MicroType-Engineering/MTE_USB_HUB/README.md

MTE_USB_HUB

As designed on the MicroType Engineering's YouTube series: https://youtu.be/uzqXgHHZUUs
