MicroType-Engineering/MTE_USB_HUB/kicad_proj/mte_usb_hub/mte_usb_hub.kicad_pcb

## KiCad design kicad_proj/mte_usb_hub/mte_usb_hub.kicad_pcb (2021-07-17)

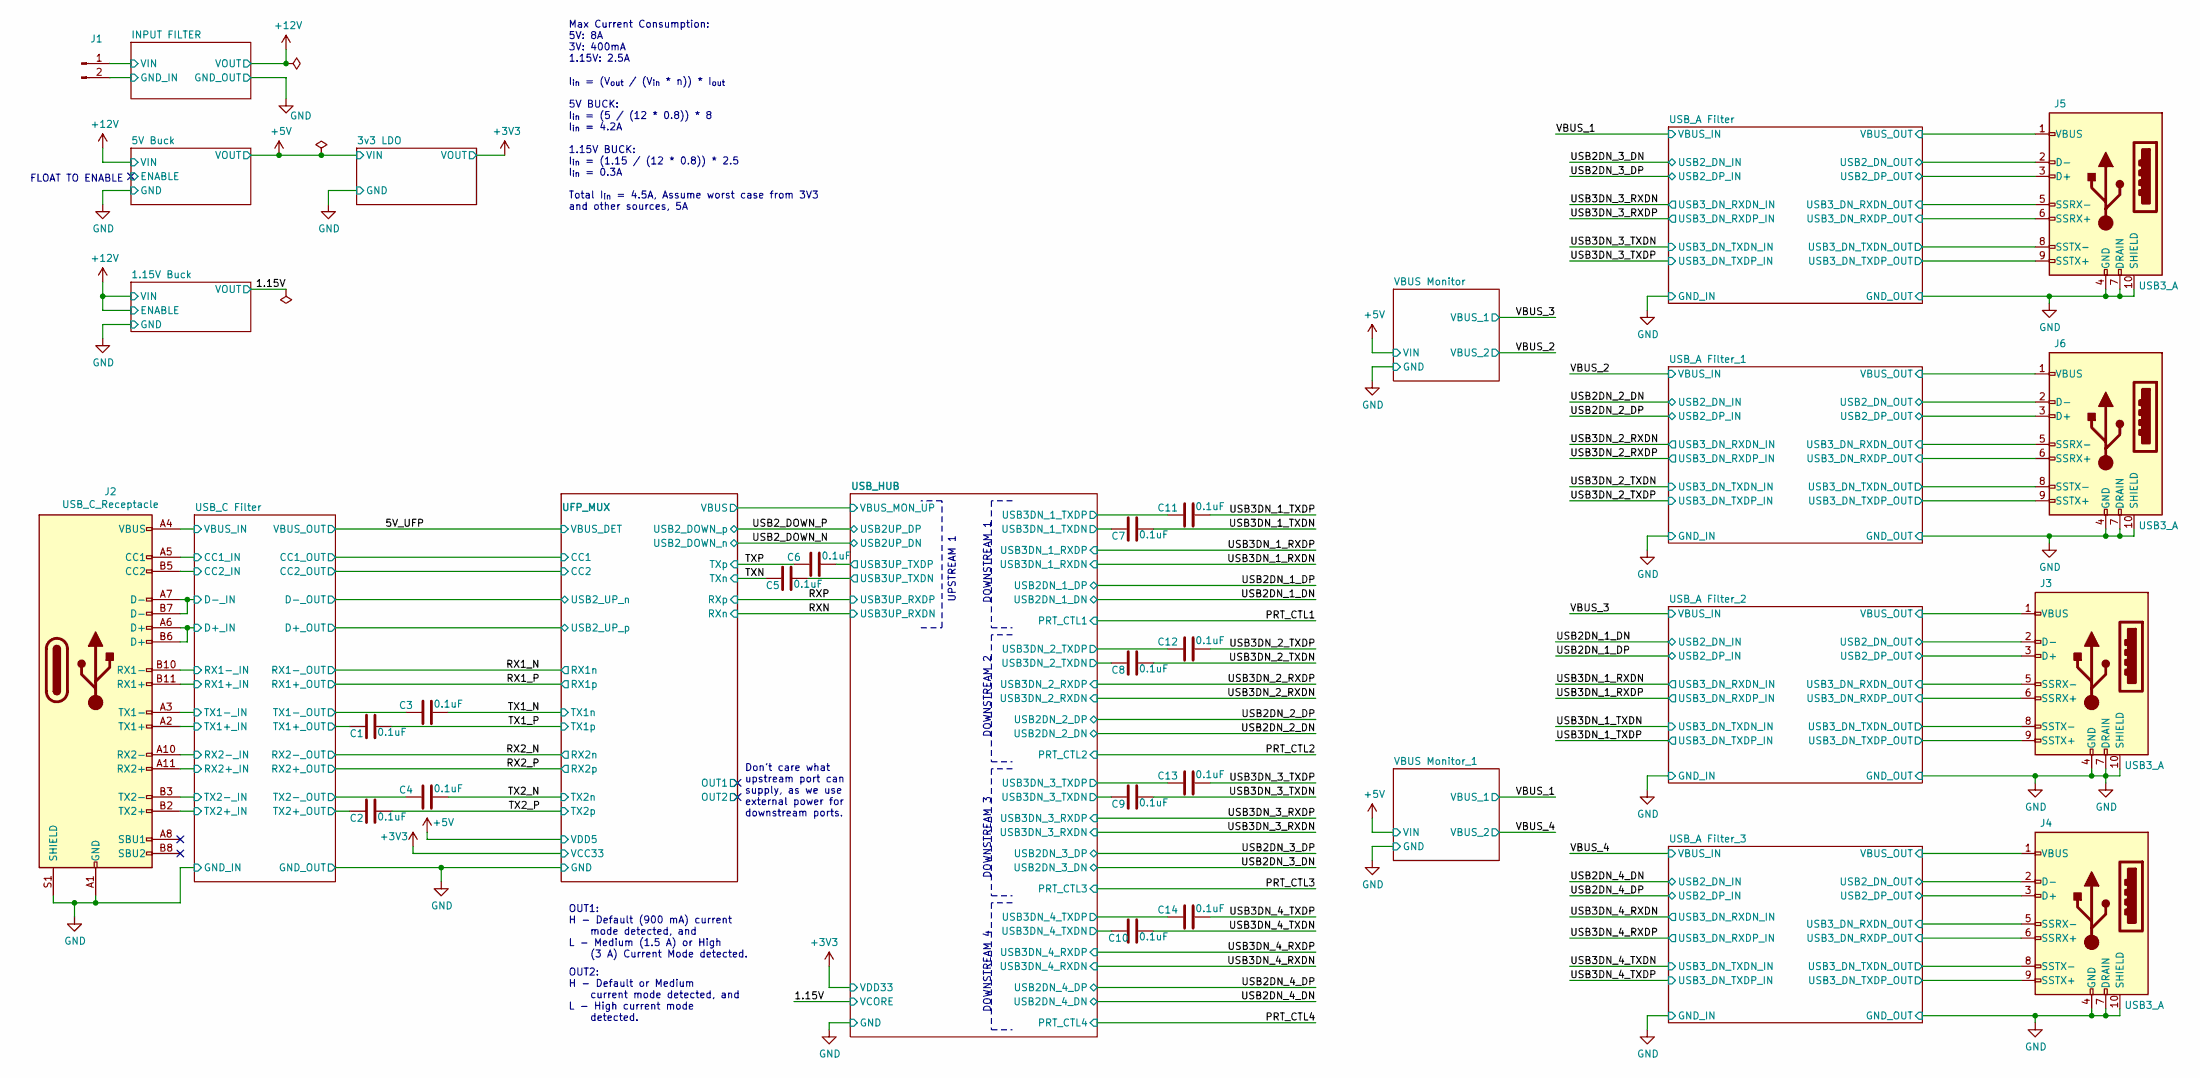
[picture p1: schematic mte_usb_hub.kicad_sch]

Parts:
C1, C2, C3, C4, C5, C6, C7, C8, C9, C10, C11, C12, C13, C14: CC0402KRX5R7BB104; CAPACITOR_0402N
J1: Conn_01x02_Male; PinHeader_1x02_P2.54mm_Vertical
J2: USB_C_Receptacle; USB_C_Receptacle_Amphenol_12401610E4-2A
J3, J4, J5, J6: USB3_A; USB3_A_Molex_48393-001

Connections:
/5V_UFP: J2.A4 (VBUS), J2.A9 (VBUS), J2.B4 (VBUS), J2.B9 (VBUS); also elsewhere on the board
/INPUT FILTER/GND_IN: J1.2; also elsewhere on the board
/INPUT FILTER/VIN: J1.1; also elsewhere on the board
/RX1_N: J2.B10 (RX1-); also elsewhere on the board
/RX1_P: J2.B11 (RX1+); also elsewhere on the board
/RX2_N: J2.A10 (RX2-); also elsewhere on the board
/RX2_P: J2.A11 (RX2+); also elsewhere on the board
/TX1_N: C3.2; also elsewhere on the board
/TX1_P: C1.2; also elsewhere on the board
/TX2_N: C4.2; also elsewhere on the board
/TX2_P: C2.2; also elsewhere on the board
/TXN: C5.1; also elsewhere on the board
/TXP: C6.1; also elsewhere on the board
/UFP_MUX/CC1: J2.A5 (CC1); also elsewhere on the board
/UFP_MUX/CC2: J2.B5 (CC2); also elsewhere on the board
/USB2DN_1_DN: J3.2 (D-); also elsewhere on the board
/USB2DN_1_DP: J3.3 (D+); also elsewhere on the board
/USB2DN_2_DN: J6.2 (D-); also elsewhere on the board
/USB2DN_2_DP: J6.3 (D+); also elsewhere on the board
/USB2DN_3_DN: J5.2 (D-); also elsewhere on the board
/USB2DN_3_DP: J5.3 (D+); also elsewhere on the board
/USB2DN_4_DN: J4.2 (D-); also elsewhere on the board
/USB2DN_4_DP: J4.3 (D+); also elsewhere on the board
/USB2_DOWN_N: J2.A7 (D-), J2.B7 (D-); also elsewhere on the board
/USB2_DOWN_P: J2.A6 (D+), J2.B6 (D+); also elsewhere on the board
/USB3DN_1_RXDN: J3.5 (SSRX-); also elsewhere on the board
/USB3DN_1_RXDP: J3.6 (SSRX+); also elsewhere on the board
/USB3DN_1_TXDN: C7.2, J3.8 (SSTX-); also elsewhere on the board
/USB3DN_1_TXDP: C11.2, J3.9 (SSTX+); also elsewhere on the board
/USB3DN_2_RXDN: J6.5 (SSRX-); also elsewhere on the board
/USB3DN_2_RXDP: J6.6 (SSRX+); also elsewhere on the board
/USB3DN_2_TXDN: C8.2, J6.8 (SSTX-); also elsewhere on the board
/USB3DN_2_TXDP: C12.2, J6.9 (SSTX+); also elsewhere on the board
/USB3DN_3_RXDN: J5.5 (SSRX-); also elsewhere on the board
/USB3DN_3_RXDP: J5.6 (SSRX+); also elsewhere on the board
/USB3DN_3_TXDN: C9.2, J5.8 (SSTX-); also elsewhere on the board
/USB3DN_3_TXDP: C13.2, J5.9 (SSTX+); also elsewhere on the board
/USB3DN_4_RXDN: J4.5 (SSRX-); also elsewhere on the board
/USB3DN_4_RXDP: J4.6 (SSRX+); also elsewhere on the board
/USB3DN_4_TXDN: C10.2, J4.8 (SSTX-); also elsewhere on the board
/USB3DN_4_TXDP: C14.2, J4.9 (SSTX+); also elsewhere on the board
/USB_C Filter/_TX1+: C1.1, J2.A2 (TX1+); also elsewhere on the board
/USB_C Filter/_TX1-: C3.1, J2.A3 (TX1-); also elsewhere on the board
/USB_C Filter/_TX2+: C2.1, J2.B2 (TX2+); also elsewhere on the board
/USB_C Filter/_TX2-: C4.1, J2.B3 (TX2-); also elsewhere on the board
/USB_HUB/USB3DN_1_TXDN: C7.1; also elsewhere on the board
/USB_HUB/USB3DN_1_TXDP: C11.1; also elsewhere on the board
/USB_HUB/USB3DN_2_TXDN: C8.1; also elsewhere on the board
/USB_HUB/USB3DN_2_TXDP: C12.1; also elsewhere on the board
/USB_HUB/USB3DN_3_TXDN: C9.1; also elsewhere on the board
/USB_HUB/USB3DN_3_TXDP: C13.1; also elsewhere on the board
/USB_HUB/USB3DN_4_TXDN: C10.1; also elsewhere on the board
/USB_HUB/USB3DN_4_TXDP: C14.1; also elsewhere on the board
/USB_HUB/USB3UP_TXDN: C5.2; also elsewhere on the board
/USB_HUB/USB3UP_TXDP: C6.2; also elsewhere on the board
/VBUS_1: J5.1 (VBUS); also elsewhere on the board
/VBUS_2: J6.1 (VBUS); also elsewhere on the board
/VBUS_3: J3.1 (VBUS); also elsewhere on the board
/VBUS_4: J4.1 (VBUS); also elsewhere on the board
GND: J2.A1 (GND), J2.A12 (GND), J2.B1 (GND), J2.B12 (GND), J2.S1 (SHIELD), J3.4 (GND), J3.7 (DRAIN), J3.10 (SHIELD), J4.4 (GND), J4.7 (DRAIN), J4.10 (SHIELD), J5.4 (GND), J5.7 (DRAIN), J5.10 (SHIELD), J6.4 (GND), J6.7 (DRAIN), J6.10 (SHIELD); also elsewhere on the board

Notes on the sheet:
FLOAT TO ENABLE
Max Current Consumption: 5V: 8A 3V: 400mA 1.15V: 2.5A
I_{in} = (V_{out} / (V_{in} * n)) * I_{out} 5V BUCK: I_{in} = (5 / (12 * 0.8)) * 8 I_{in} = 4.2A 1.15V BUCK: I_{in} = (1.15 / (12 * 0.8)) * 2.5 I_{in} = 0.3A Total I_{in} = 4.5A, Assume worst case from 3V3 and other sources, 5A
OUT1: H - Default (900 mA) current mode detected, and L - Medium (1.5 A) or High (3 A) Current Mode detected.
OUT2: H - Default or Medium current mode detected, and L - High current mode detected.
Don't care what upstream port can supply, as we use external power for downstream ports.
UPSTREAM 1
DOWNSTREAM 1
DOWNSTREAM 2
DOWNSTREAM 3
DOWNSTREAM 4

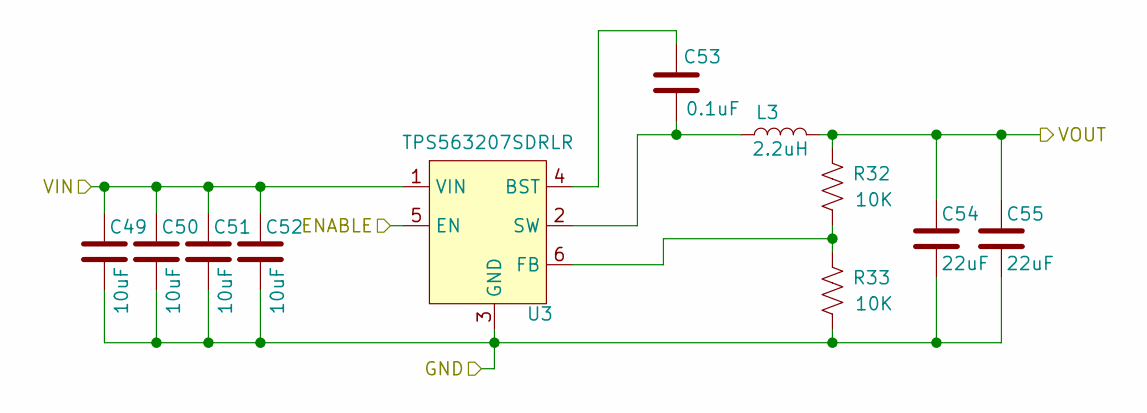
[picture p2: schematic 1.15v_buck.kicad_sch]

Parts:
C49, C50, C51, C52: GRM31CR71E106KA12L; CAPACITOR_1206N
C53: CC0402KRX5R7BB104; CAPACITOR_0402N
C54, C55: CL21A226MOCLRNC; CAPACITOR_0805N
L3: 74405042022; INDM400X400X200L95X310N
R32, R33: RC0402JR-0710KL; RESISTOR_0402N
U3: TPS563207SDRLR; SOL6P50_160X160X60L21N

Connections:
+12V: C49.1, C50.1, C51.1, C52.1, U3.1 (VIN), U3.5 (EN); also elsewhere on the board
/1.15V: C54.1, C55.1, L3.2, R32.1; also elsewhere on the board
GND: C49.2, C50.2, C51.2, C52.2, C54.2, C55.2, R33.2, U3.3 (GND); also elsewhere on the board
unnamed: C53.1, L3.1, U3.2 (SW)
unnamed: C53.2, U3.4 (BST)
unnamed: R32.2, R33.1, U3.6 (FB)

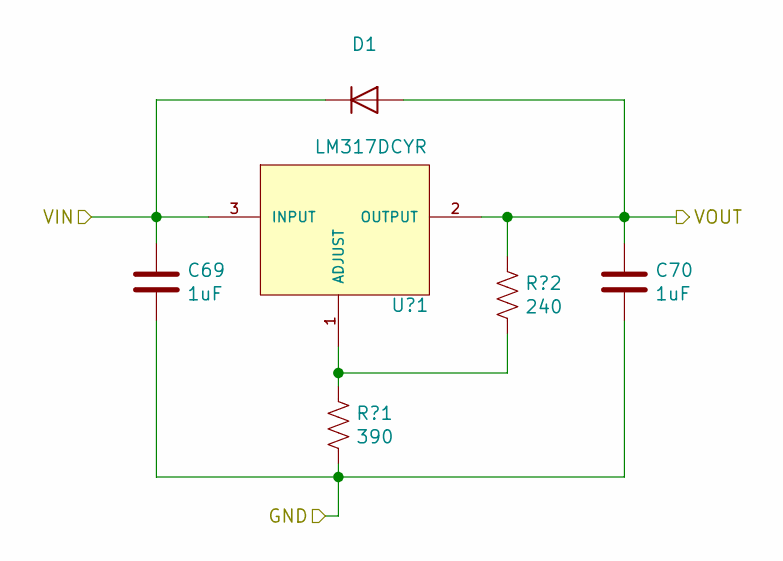
[picture p3: schematic 3v3_ldo.kicad_sch]

Parts:
C69, C70: CC0402KRX5R7BB105; CAPACITOR_0402N
D1: BAS16GWJ; SODFL360X160X130L45X62N
R?1: RC0402FR-07390RL; RESISTOR_0402N
R?2: RC0402JR-07240RL; RESISTOR_0402N
U?1: LM317DCYR; SOT223-4P230_700X180L80X75N

Connections:
+3V3: C70.1, D1.A, R?2.1, U?1.2 (OUTPUT), U?1.4 (OUTPUT); also elsewhere on the board
+5V: C69.1, D1.C (K), U?1.3 (INPUT); also elsewhere on the board
GND: C69.2, C70.2, R?1.2; also elsewhere on the board
unnamed: R?1.1, R?2.2, U?1.1 (ADJUST)

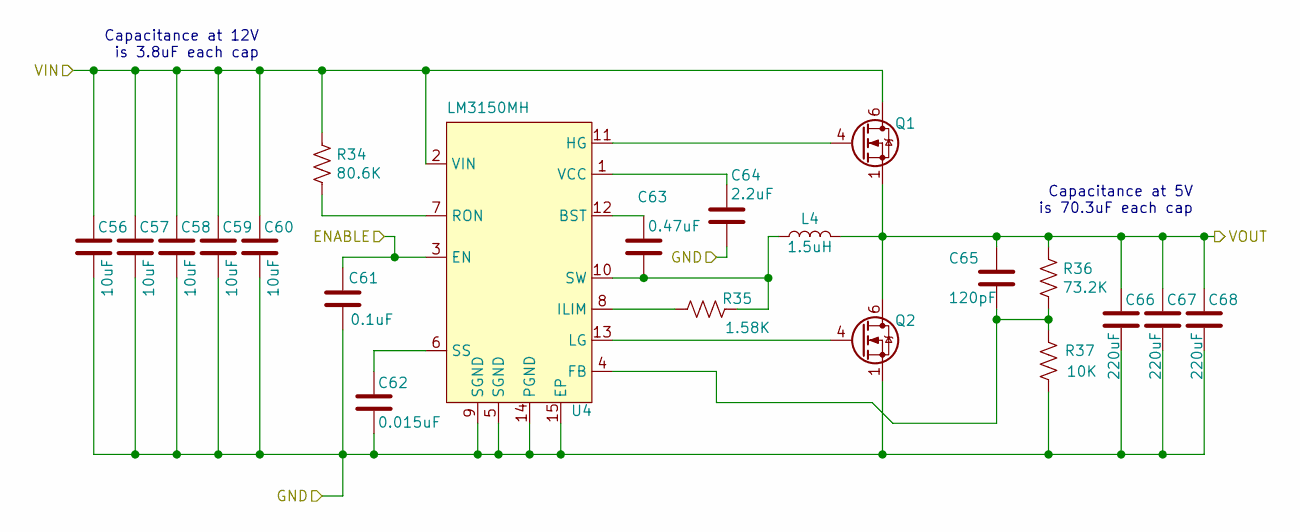
[picture p4: schematic 5v_buck.kicad_sch]

Parts:
C56, C57, C58, C59, C60: GRM31CR71E106KA12L; CAPACITOR_1206N
C61: CC0402KRX5R7BB104; CAPACITOR_0402N
C62: TMK105BJ153KV-F; CAPACITOR_0402N
C63: TMK105ABJ474KV-F; CAPACITOR_0402N
C64: TMK105CBJ225MV-F; CAPACITOR_0402N
C65: C0402C121J3GAC7867; CAPACITOR_0402N
C66, C67, C68: GRM32ER60J227ME05L; CAPACITOR_1210N
L4: SRP1270-1R5M; INDM1350X1350X700L250X300N
Q1: CSD16342Q5A
Q2: CSD17577Q5AT; CSD16342Q5A
R34: RC0402FR-0780K6L; RESISTOR_0402N
R35: RC0402FR-071K58L; RESISTOR_0402N
R36: RC0402FR-0773K2L; RESISTOR_0402N
R37: RC0402JR-0710KL; RESISTOR_0402N
U4: LM3150MH; SOP15P65_500X640X110L60X24T310X300N

Connections:
+5V: C65.1, C66.1, C67.1, C68.1, L4.2, Q1.1 (S), Q1.2 (S), Q1.3 (S), Q2.5 (D), Q2.6 (D), Q2.7 (D), Q2.8 (D), R36.1; also elsewhere on the board
+12V: C56.1, C57.1, C58.1, C59.1, C60.1, Q1.5 (D), Q1.6 (D), Q1.7 (D), Q1.8 (D), R34.1, U4.2 (VIN); also elsewhere on the board
/5V Buck/ENABLE: C61.2, U4.3 (EN)
GND: C56.2, C57.2, C58.2, C59.2, C60.2, C61.1, C62.2, C64.2, C66.2, C67.2, C68.2, Q2.1 (S), Q2.2 (S), Q2.3 (S), R37.2, U4.5 (SGND), U4.9 (SGND), U4.14 (PGND), U4.15 (EP); also elsewhere on the board
unnamed: C62.1, U4.6 (SS)
unnamed: C63.1, U4.12 (BST)
unnamed: C63.2, L4.1, R35.2, U4.10 (SW)
unnamed: C64.1, U4.1 (VCC)
unnamed: C65.2, R36.2, R37.1, U4.4 (FB)
unnamed: Q1.4 (G), U4.11 (HG)
unnamed: Q2.4 (G), U4.13 (LG)
unnamed: R34.2, U4.7 (RON)
unnamed: R35.1, U4.8 (ILIM)

Notes on the sheet:
Capacitance at 12V is 3.8uF each cap
Capacitance at 5V is 70.3uF each cap

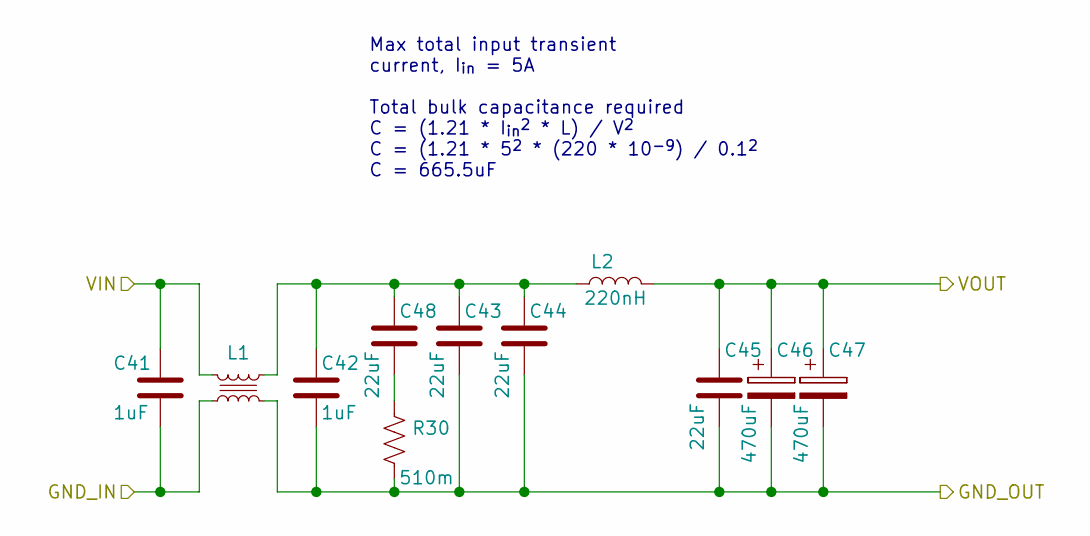
[picture p5: schematic input_filter.kicad_sch]

Parts:
C41, C42: CC0603KRX5R9BB105; CAPACITOR_0603N
C43, C44, C45, C48: GCJ32EC71E226KE02; CAPACITOR_1210N
C46, C47: EEE-HAE471UAP; CAPAE1030X1080L350X120N
L1: ACM1211-701-2PL-TL01
L2: FCUL0624-H-R22M=P3; INDM730X660X240L150X140N
R30: RL1206JR-070R51L; RESISTOR_1206N

Connections:
+12V: C45.1, C46.1, C47.1, L2.2; also elsewhere on the board
/INPUT FILTER/GND_IN: C41.2, L1.2; also elsewhere on the board
/INPUT FILTER/VIN: C41.1, L1.1; also elsewhere on the board
GND: C42.2, C43.2, C44.2, C45.2, C46.2, C47.2, L1.3, R30.2; also elsewhere on the board
unnamed: C42.1, C43.1, C44.1, C48.1, L1.4, L2.1
unnamed: C48.2, R30.1

Notes on the sheet:
Max total input transient current, I_{in} = 5A Total bulk capacitance required C = (1.21 * I_{in}^{2} * L) / V^{2} C = (1.21 * 5^{2} * (220 * 10^{-9}) / 0.1^{2} C = 665.5uF

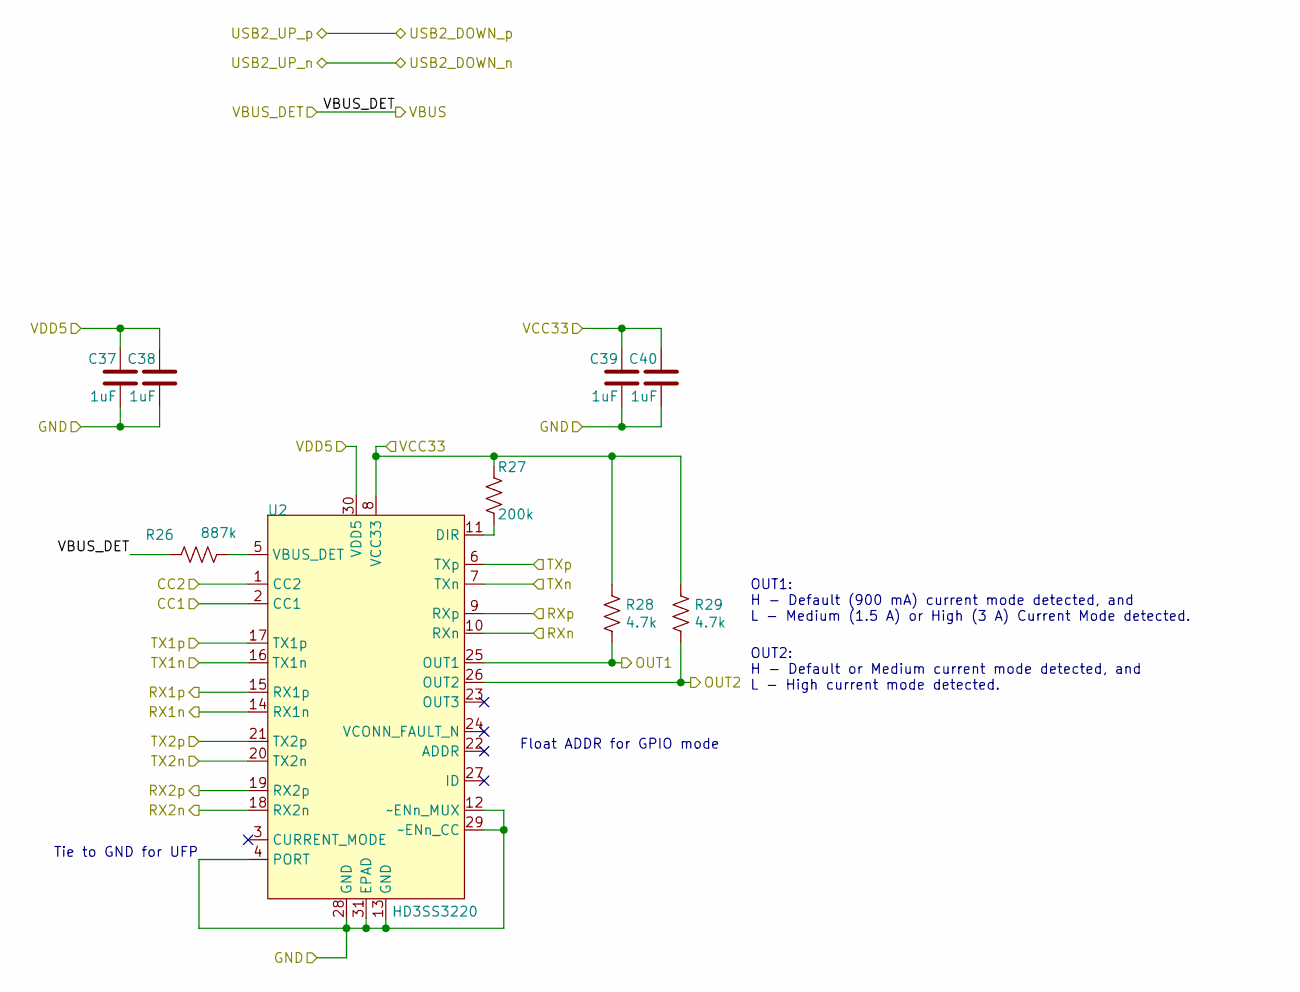
[picture p6: schematic UFP_MUX.kicad_sch]

Parts:
C37, C38, C39, C40: CC0402KRX5R7BB105; CAPACITOR_0402N
R26: RC0402FR-07887KL; RESISTOR_0402N
R27: RC0402JR-07200KL; RESISTOR_0402N
R28, R29: RC0402JR-074K7L; RESISTOR_0402N
U2: HD3SS3220; QFN31P40_250X450X80L30X20T120X320N

Connections:
+3V3: C39.1, C40.1, R27.1, R28.1, R29.1, U2.8 (VCC33); also elsewhere on the board
+5V: C37.1, C38.1, U2.30 (VDD5); also elsewhere on the board
/5V_UFP: R26.1; also elsewhere on the board
/RX1_N: U2.14 (RX1n); also elsewhere on the board
/RX1_P: U2.15 (RX1p); also elsewhere on the board
/RX2_N: U2.18 (RX2n); also elsewhere on the board
/RX2_P: U2.19 (RX2p); also elsewhere on the board
/RXN: U2.10 (RXn); also elsewhere on the board
/RXP: U2.9 (RXp); also elsewhere on the board
/TX1_N: U2.16 (TX1n); also elsewhere on the board
/TX1_P: U2.17 (TX1p); also elsewhere on the board
/TX2_N: U2.20 (TX2n); also elsewhere on the board
/TX2_P: U2.21 (TX2p); also elsewhere on the board
/TXN: U2.7 (TXn); also elsewhere on the board
/TXP: U2.6 (TXp); also elsewhere on the board
/UFP_MUX/CC1: U2.2 (CC1); also elsewhere on the board
/UFP_MUX/CC2: U2.1 (CC2); also elsewhere on the board
/UFP_MUX/OUT1: R28.2, U2.25 (OUT1)
/UFP_MUX/OUT2: R29.2, U2.26 (OUT2)
GND: C37.2, C38.2, C39.2, C40.2, U2.4 (PORT), U2.12 (~ENn_MUX), U2.13 (GND), U2.28 (GND), U2.29 (~ENn_CC), U2.31 (EPAD); also elsewhere on the board
unnamed: R26.2, U2.5 (VBUS_DET)
unnamed: R27.2, U2.11 (DIR)

Notes on the sheet:
Tie to GND for UFP
Float ADDR for GPIO mode
OUT1: H - Default (900 mA) current mode detected, and L - Medium (1.5 A) or High (3 A) Current Mode detected.
OUT2: H - Default or Medium current mode detected, and L - High current mode detected.

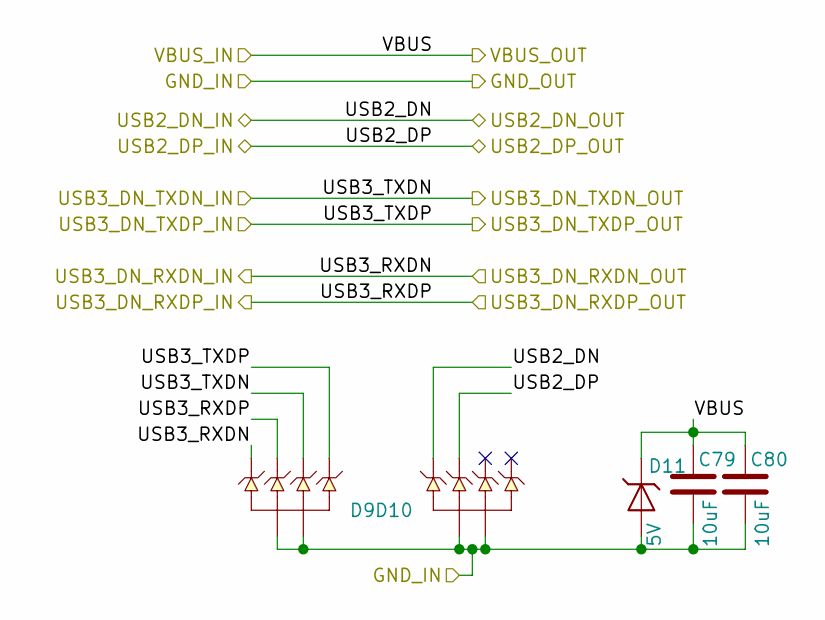
[picture p7: schematic usb_a_filter.kicad_sch]

Parts:
C79, C80: GRM21BR61H106ME43; CAPACITOR_0805N
D9, D10: ESD8004MUTAG
D11: ESD9X3.3ST5G; SODFL1006X43N

Connections:
/USB2DN_2_DN: D10.5, D10.6; also elsewhere on the board
/USB2DN_2_DP: D10.4, D10.7; also elsewhere on the board
/USB3DN_2_RXDN: D9.1, D9.10; also elsewhere on the board
/USB3DN_2_RXDP: D9.2, D9.9; also elsewhere on the board
/USB3DN_2_TXDN: D9.4, D9.7; also elsewhere on the board
/USB3DN_2_TXDP: D9.5, D9.6; also elsewhere on the board
/VBUS_2: C79.1, C80.1, D11.C; also elsewhere on the board
GND: C79.2, C80.2, D9.3, D9.8, D10.3, D10.8, D11.A; also elsewhere on the board

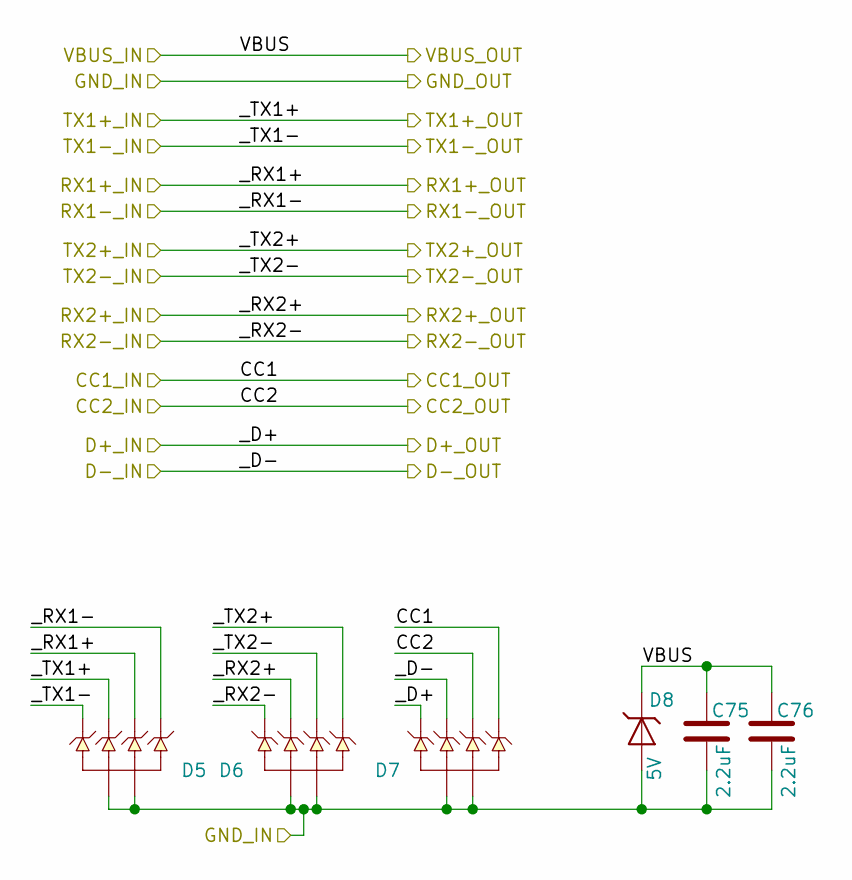
[picture p8: schematic usb_c_filter.kicad_sch]

Parts:
C75, C76: TMK105CBJ225MV-F; CAPACITOR_0402N
D5, D6, D7: ESD8004MUTAG
D8: ESD9X3.3ST5G; SODFL1006X43N

Connections:
/5V_UFP: C75.1, C76.1, D8.C; also elsewhere on the board
/RX1_N: D5.5, D5.6; also elsewhere on the board
/RX1_P: D5.4, D5.7; also elsewhere on the board
/RX2_N: D6.5, D6.6; also elsewhere on the board
/RX2_P: D6.4, D6.7; also elsewhere on the board
/UFP_MUX/CC1: D7.1, D7.10; also elsewhere on the board
/UFP_MUX/CC2: D7.2, D7.9; also elsewhere on the board
/USB2_DOWN_N: D7.4, D7.7; also elsewhere on the board
/USB2_DOWN_P: D7.5, D7.6; also elsewhere on the board
/USB_C Filter/_TX1+: D5.2, D5.9; also elsewhere on the board
/USB_C Filter/_TX1-: D5.1, D5.10; also elsewhere on the board
/USB_C Filter/_TX2+: D6.1, D6.10; also elsewhere on the board
/USB_C Filter/_TX2-: D6.2, D6.9; also elsewhere on the board
GND: C75.2, C76.2, D5.3, D5.8, D6.3, D6.8, D7.3, D7.8, D8.A; also elsewhere on the board

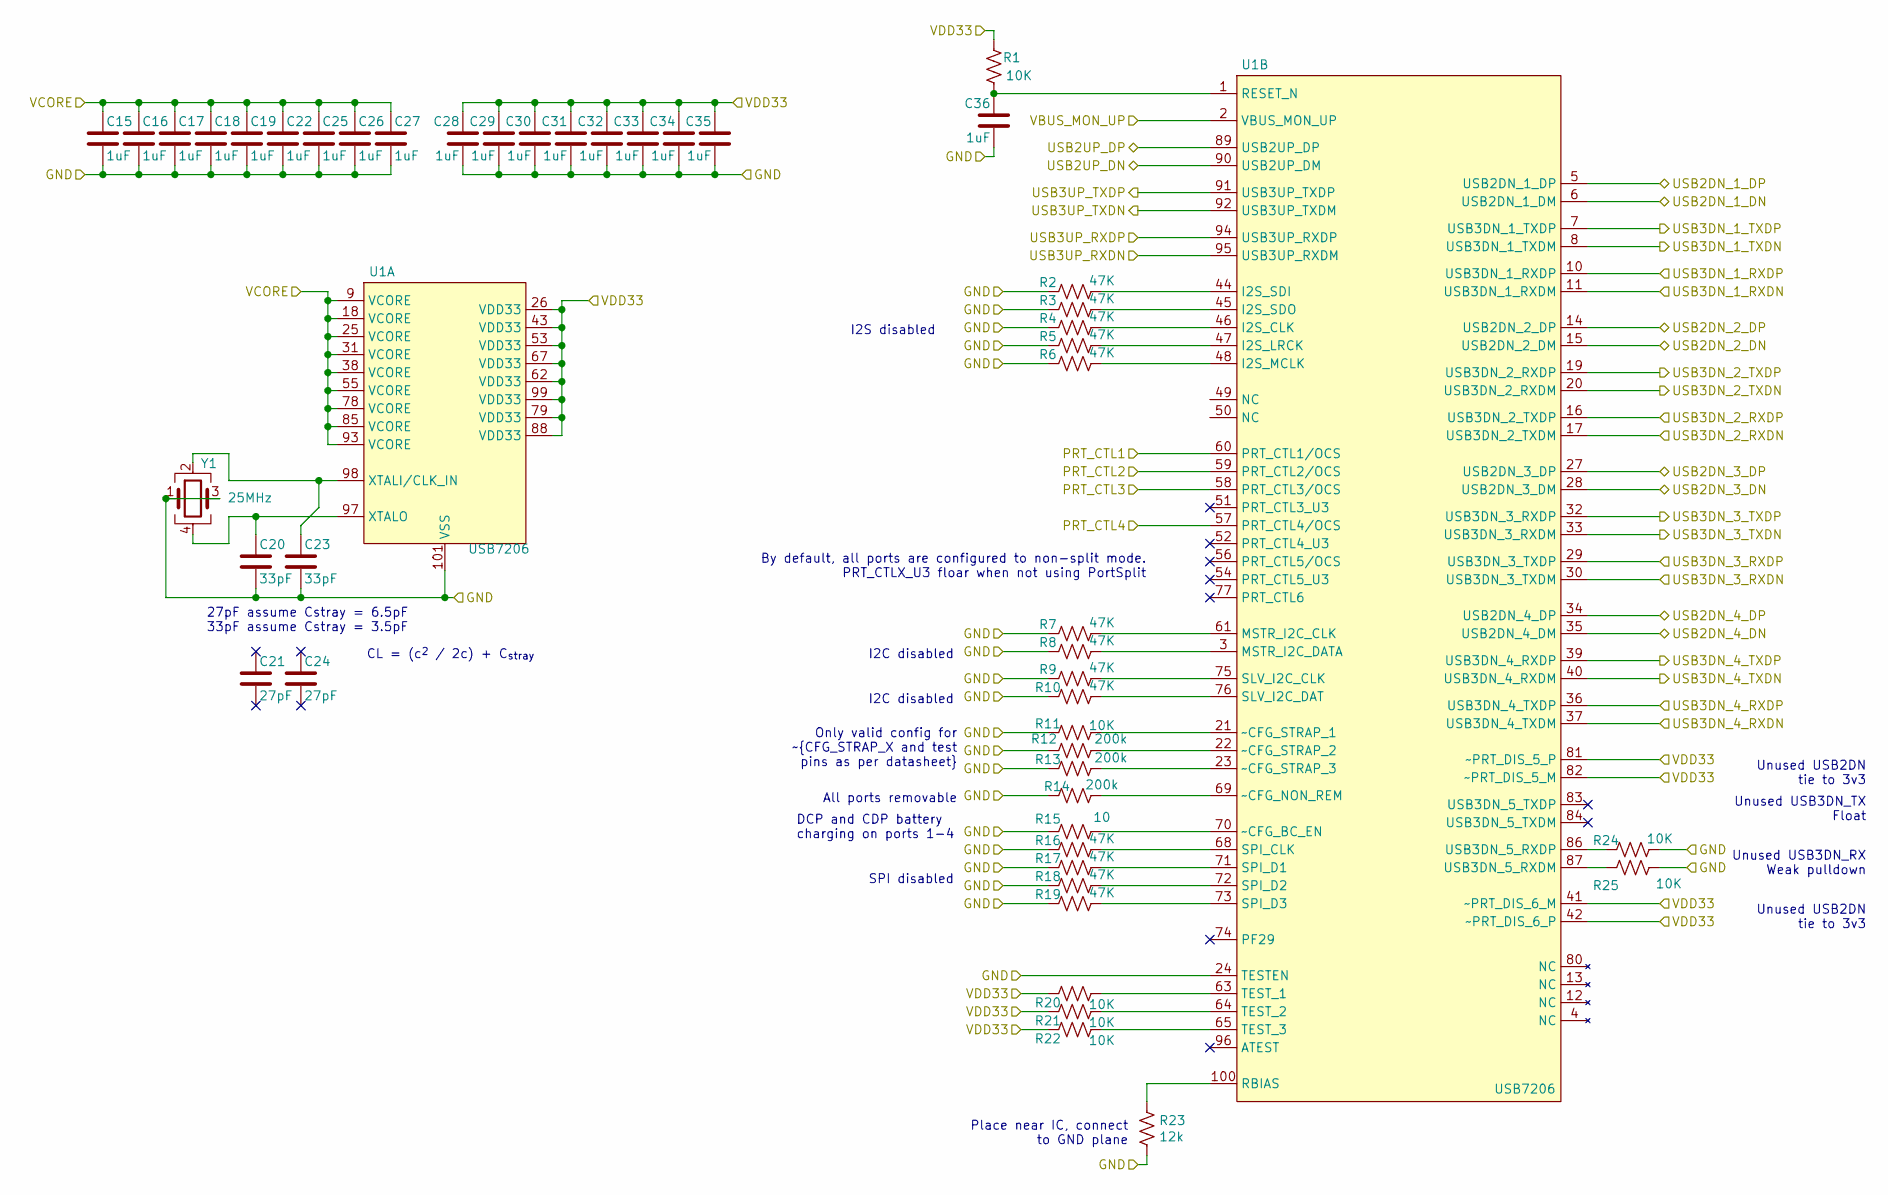
[picture p9: schematic USB_HUB.kicad_sch]

Parts:
C15, C16, C17, C18, C19, C22, C25, C26, C27, C28, C29, C30, C31, C32, C33, C34, C35, C36: CC0402KRX5R7BB105; CAPACITOR_0402N
C20, C23: CC0402JRNPO9BN330; CAPACITOR_0402N
C21, C24: CC0402JRNPO9BN270; CAPACITOR_0402N
R1, R11, R20, R21, R22, R24, R25: RC0402JR-0710KL; RESISTOR_0402N
R2, R3, R4, R5, R6, R7, R8, R9, R10, R16, R17, R18, R19: RC0402JR-0747KL; RESISTOR_0402N
R12, R13, R14: RC0402JR-07200KL; RESISTOR_0402N
R15: RC0402JR-0710RL; RESISTOR_0402N
R23: RT0402DRE0712KL; RESISTOR_0402N
U1: USB7206; QFN101P40_1200X1200X90L60X20T800N
Y1: RH100-25.000-20-F-1030-TR; RH100-12.000-10-2020-EXT-TR

Connections:
+3V3: C28.1, C29.1, C30.1, C31.1, C32.1, C33.1, C34.1, C35.1, R1.2, R20.2, R21.2, R22.2, U1.26 (VDD33), U1.41 (~PRT_DIS_6_M), U1.42 (~PRT_DIS_6_P), U1.43 (VDD33), U1.53 (VDD33), U1.62 (VDD33), U1.67 (VDD33), U1.79 (VDD33), U1.81 (~PRT_DIS_5_P), U1.82 (~PRT_DIS_5_M), U1.88 (VDD33), U1.99 (VDD33); also elsewhere on the board
/1.15V: C15.1, C16.1, C17.1, C18.1, C19.1, C22.1, C25.1, C26.1, C27.1, U1.9 (VCORE), U1.18 (VCORE), U1.25 (VCORE), U1.31 (VCORE), U1.38 (VCORE), U1.55 (VCORE), U1.78 (VCORE), U1.85 (VCORE), U1.93 (VCORE); also elsewhere on the board
/5V_UFP: U1.2 (VBUS_MON_UP); also elsewhere on the board
/PRT_CTL1: U1.60 (PRT_CTL1/OCS)
/PRT_CTL2: U1.59 (PRT_CTL2/OCS)
/PRT_CTL3: U1.58 (PRT_CTL3/OCS)
/PRT_CTL4: U1.57 (PRT_CTL4/OCS)
/RXN: U1.95 (USB3UP_RXDM); also elsewhere on the board
/RXP: U1.94 (USB3UP_RXDP); also elsewhere on the board
/USB2DN_1_DN: U1.6 (USB2DN_1_DM); also elsewhere on the board
/USB2DN_1_DP: U1.5 (USB2DN_1_DP); also elsewhere on the board
/USB2DN_2_DN: U1.15 (USB2DN_2_DM); also elsewhere on the board
/USB2DN_2_DP: U1.14 (USB2DN_2_DP); also elsewhere on the board
/USB2DN_3_DN: U1.28 (USB2DN_3_DM); also elsewhere on the board
/USB2DN_3_DP: U1.27 (USB2DN_3_DP); also elsewhere on the board
/USB2DN_4_DN: U1.35 (USB2DN_4_DM); also elsewhere on the board
/USB2DN_4_DP: U1.34 (USB2DN_4_DP); also elsewhere on the board
/USB2_DOWN_N: U1.90 (USB2UP_DM); also elsewhere on the board
/USB2_DOWN_P: U1.89 (USB2UP_DP); also elsewhere on the board
/USB3DN_1_RXDN: U1.11 (USB3DN_1_RXDM); also elsewhere on the board
/USB3DN_1_RXDP: U1.10 (USB3DN_1_RXDP); also elsewhere on the board
/USB3DN_2_RXDN: U1.17 (USB3DN_2_TXDM); also elsewhere on the board
/USB3DN_2_RXDP: U1.16 (USB3DN_2_TXDP); also elsewhere on the board
/USB3DN_3_RXDN: U1.30 (USB3DN_3_TXDM); also elsewhere on the board
/USB3DN_3_RXDP: U1.29 (USB3DN_3_TXDP); also elsewhere on the board
/USB3DN_4_RXDN: U1.37 (USB3DN_4_TXDM); also elsewhere on the board
/USB3DN_4_RXDP: U1.36 (USB3DN_4_TXDP); also elsewhere on the board
/USB_HUB/USB3DN_1_TXDN: U1.8 (USB3DN_1_TXDM); also elsewhere on the board
/USB_HUB/USB3DN_1_TXDP: U1.7 (USB3DN_1_TXDP); also elsewhere on the board
/USB_HUB/USB3DN_2_TXDN: U1.20 (USB3DN_2_RXDM); also elsewhere on the board
/USB_HUB/USB3DN_2_TXDP: U1.19 (USB3DN_2_RXDP); also elsewhere on the board
/USB_HUB/USB3DN_3_TXDN: U1.33 (USB3DN_3_RXDM); also elsewhere on the board
/USB_HUB/USB3DN_3_TXDP: U1.32 (USB3DN_3_RXDP); also elsewhere on the board
/USB_HUB/USB3DN_4_TXDN: U1.40 (USB3DN_4_RXDM); also elsewhere on the board
/USB_HUB/USB3DN_4_TXDP: U1.39 (USB3DN_4_RXDP); also elsewhere on the board
/USB_HUB/USB3UP_TXDN: U1.92 (USB3UP_TXDM); also elsewhere on the board
/USB_HUB/USB3UP_TXDP: U1.91 (USB3UP_TXDP); also elsewhere on the board
GND: C15.2, C16.2, C17.2, C18.2, C19.2, C20.2, C22.2, C23.2, C25.2, C26.2, C27.2, C28.2, C29.2, C30.2, C31.2, C32.2, C33.2, C34.2, C35.2, C36.2, R2.1, R3.1, R4.1, R5.1, R6.1, R7.1, R8.1, R9.1, R10.1, R11.2, R12.2, R13.2, R14.2, R15.1, R16.1, R17.1, R18.1, R19.1, R23.2, R24.2, R25.2, U1.24 (TESTEN), U1.101 (VSS), Y1.1, Y1.3; also elsewhere on the board
unnamed: C20.1, U1.97 (XTALO), Y1.4
unnamed: C36.1, R1.1, U1.1 (RESET_N)
unnamed: R2.2, U1.44 (I2S_SDI)
unnamed: R3.2, U1.45 (I2S_SDO)
unnamed: R4.2, U1.46 (I2S_CLK)
unnamed: R5.2, U1.47 (I2S_LRCK)
unnamed: R6.2, U1.48 (I2S_MCLK)
unnamed: R7.2, U1.61 (MSTR_I2C_CLK)
unnamed: R8.2, U1.3 (MSTR_I2C_DATA)
unnamed: R9.2, U1.75 (SLV_I2C_CLK)
unnamed: R10.2, U1.76 (SLV_I2C_DAT)
unnamed: R11.1, U1.21 (~CFG_STRAP_1)
unnamed: R12.1, U1.22 (~CFG_STRAP_2)
unnamed: R13.1, U1.23 (~CFG_STRAP_3)
unnamed: R14.1, U1.69 (~CFG_NON_REM)
unnamed: R15.2, U1.70 (~CFG_BC_EN)
unnamed: R16.2, U1.68 (SPI_CLK)
unnamed: R17.2, U1.71 (SPI_D1)
unnamed: R18.2, U1.72 (SPI_D2)
unnamed: R19.2, U1.73 (SPI_D3)
unnamed: R20.1, U1.63 (TEST_1)
unnamed: R21.1, U1.64 (TEST_2)
unnamed: R22.1, U1.65 (TEST_3)
unnamed: R23.1, U1.100 (RBIAS)
unnamed: R24.1, U1.86 (USB3DN_5_RXDP)
unnamed: R25.1, U1.87 (USB3DN_5_RXDM)
unnamed: C23.1, U1.98 (XTALI/CLK_IN), Y1.2

Notes on the sheet:
27pF assume Cstray = 6.5pF 33pF assume Cstray = 3.5pF
CL = (c^{2} / 2c) + C_{stray}
DCP and CDP battery charging on ports 1-4
I2S disabled
I2C disabled
SPI disabled
Only valid config for ~{CFG_STRAP_X and test pins as per datasheet}
All ports removable
Place near IC, connect to GND plane
By default, all ports are configured to non-split mode. PRT_CTLX_U3 floar when not using PortSplit
Unused USB2DN tie to 3v3
Unused USB3DN_TX Float
Unused USB3DN_RX Weak pulldown

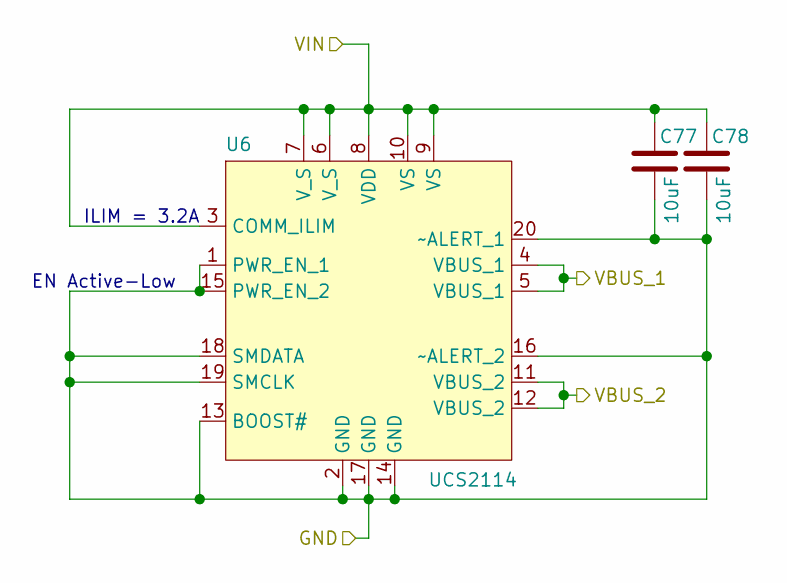
[picture p10: schematic vbus_monitor.kicad_sch]

Parts:
C77, C78: GRM21BR61H106ME43; CAPACITOR_0805N
U6: UCS2114

Connections:
+5V: C77.1, C78.1, U6.3 (COMM_ILIM), U6.6 (V_S), U6.7 (V_S), U6.8 (VDD), U6.9 (VS), U6.10 (VS); also elsewhere on the board
/VBUS_1: U6.4 (VBUS_1), U6.5 (VBUS_1); also elsewhere on the board
/VBUS_4: U6.11 (VBUS_2), U6.12 (VBUS_2); also elsewhere on the board
GND: C77.2, C78.2, U6.1 (PWR_EN_1), U6.2 (GND), U6.13 (BOOST#), U6.14 (GND), U6.15 (PWR_EN_2), U6.16 (~ALERT_2), U6.17 (GND), U6.18 (SMDATA), U6.19 (SMCLK), U6.20 (~ALERT_1); also elsewhere on the board

Notes on the sheet:
EN Active-Low
ILIM = 3.2A

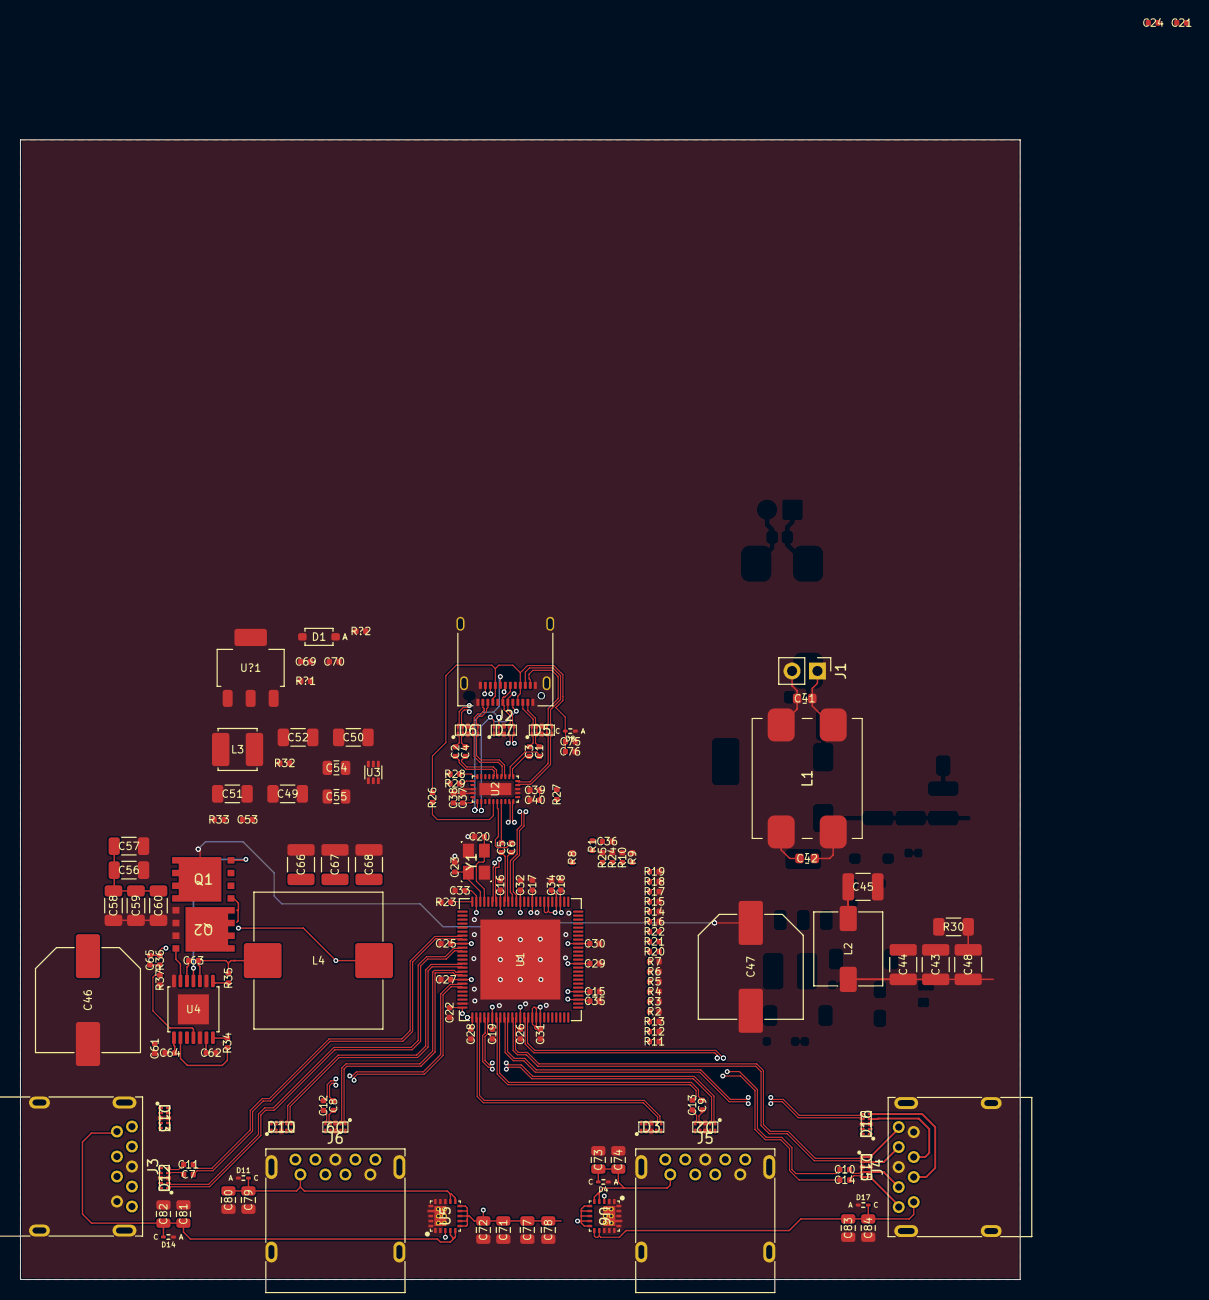
[picture p11: board mte_usb_hub.kicad_pcb from above]

Board: 6 copper layers, 100.0 x 114.0 mm, 159 parts (0 on the bottom side), 113 nets.

Other parts of the board:
C71, C72, C73, C74, C81, C82, C83, C84: GRM21BR61H106ME43; CAPACITOR_0805N
D2, D3, D12, D13, D15, D16: ESD8004MUTAG
D4, D14, D17: ESD9X3.3ST5G; SODFL1006X43N
U5: UCS2114

Their connections:
+5V: C71.1, C72.1, U5.3 (COMM_ILIM), U5.6 (V_S), U5.7 (V_S), U5.8 (VDD), U5.9 (VS), U5.10 (VS); also elsewhere on the board
/USB2DN_1_DN: D13.5, D13.6; also elsewhere on the board
/USB2DN_1_DP: D13.4, D13.7; also elsewhere on the board
/USB2DN_3_DN: D3.5, D3.6; also elsewhere on the board
/USB2DN_3_DP: D3.4, D3.7; also elsewhere on the board
/USB2DN_4_DN: D16.5, D16.6; also elsewhere on the board
/USB2DN_4_DP: D16.4, D16.7; also elsewhere on the board
/USB3DN_1_RXDN: D12.1, D12.10; also elsewhere on the board
/USB3DN_1_RXDP: D12.2, D12.9; also elsewhere on the board
/USB3DN_1_TXDN: D12.4, D12.7; also elsewhere on the board
/USB3DN_1_TXDP: D12.5, D12.6; also elsewhere on the board
/USB3DN_3_RXDN: D2.1, D2.10; also elsewhere on the board
/USB3DN_3_RXDP: D2.2, D2.9; also elsewhere on the board
/USB3DN_3_TXDN: D2.4, D2.7; also elsewhere on the board
/USB3DN_3_TXDP: D2.5, D2.6; also elsewhere on the board
/USB3DN_4_RXDN: D15.1, D15.10; also elsewhere on the board
/USB3DN_4_RXDP: D15.2, D15.9; also elsewhere on the board
/USB3DN_4_TXDN: D15.4, D15.7; also elsewhere on the board
/USB3DN_4_TXDP: D15.5, D15.6; also elsewhere on the board
/VBUS_1: C73.1, C74.1, D4.C; also elsewhere on the board
/VBUS_2: U5.11 (VBUS_2), U5.12 (VBUS_2); also elsewhere on the board
/VBUS_3: C81.1, C82.1, D14.C, U5.4 (VBUS_1), U5.5 (VBUS_1); also elsewhere on the board
/VBUS_4: C83.1, C84.1, D17.C; also elsewhere on the board
GND: C71.2, C72.2, C73.2, C74.2, C81.2, C82.2, C83.2, C84.2, D2.3, D2.8, D3.3, D3.8, D4.A, D12.3, D12.8, D13.3, D13.8, D14.A, D15.3, D15.8, D16.3, D16.8, D17.A, U5.1 (PWR_EN_1), U5.2 (GND), U5.13 (BOOST#), U5.14 (GND), U5.15 (PWR_EN_2), U5.16 (~ALERT_2), U5.17 (GND), U5.18 (SMDATA), U5.19 (SMCLK), U5.20 (~ALERT_1); also elsewhere on the board
