MicroType-Engineering/MTE_USB_HUB/(commit log)

2021-03-16 Parts created from video one
    [mte_usb_hub.kicad_pcb, mte_usb_hub.kicad_sch]
2021-03-17 Initial setup of USB hub configurations
    [USB_HUB.kicad_sch, mte_usb_hub.kicad_sch]
2021-03-17 Changes sheet pwr location
    Mainly to test Discord Webhook
    [mte_usb_hub.kicad_sch]
2021-03-19 Finishes upstream USB setup
    No power setup, no downstream ports setup
    [UFP_MUX.kicad_sch, USB_HUB.kicad_sch, mte_usb_hub.kicad_sch]
2021-03-19 Starts downstream ports
    [mte_usb_hub.kicad_sch]
2021-03-19 Final tweaks for the video
    [UFP_MUX.kicad_sch, USB_HUB.kicad_sch, mte_usb_hub.kicad_sch]
2021-04-11 Fixes Tx1/Tx2 being swapped from USB C UFP
    [mte_usb_hub.kicad_sch]
2021-04-11 Starts power design
    Input buck started from 12V -> 5V. One per 2 ports
    [mte_usb_hub.kicad_sch]
2021-04-13 Continues power design, replaces Micron Buck with a TI
    Micron had a trash datasheet
    [buck_reg.kicad_sch, input_filter.kicad_sch, mte_usb_hub.kicad_sch, untitled.kicad_sch]
2021-04-15 New buck regulator added
    [5v_buck.kicad_sch, mte_usb_hub.kicad_sch]
2021-04-15 Adds 1v15 buck
    [1.15v_buck.kicad_sch, mte_usb_hub.kicad_sch]
2021-04-24 Adds 3v3 LDO
    [3v3_ldo.kicad_sch, mte_usb_hub.kicad_sch]
2021-04-24 Implements VBUS monitor, starts ESD protection
    [5v_buck.kicad_sch, mte_usb_hub.kicad_sch, vbus_monitor.kicad_sch]
2021-04-28 Finishes input filter, minor buck changes
    [1.15v_buck.kicad_sch, 5v_buck.kicad_sch, input_filter.kicad_sch, mte_usb_hub.kicad_sch, usb_a_filter.kicad_sch, vbus_monitor.kicad_sch]
2021-04-28 Adds bulk capacitors on 12V input
    [input_filter.kicad_sch, mte_usb_hub.kicad_sch]
2021-05-31 Updates input protection, output BC enabled
    [1.15v_buck.kicad_sch, 3v3_ldo.kicad_sch, 5v_buck.kicad_sch, UFP_MUX.kicad_sch, USB_HUB.kicad_sch, input_filter.kicad_sch, mte_usb_hub.kicad_sch, usb_a_filter.kicad_sch]
2021-06-12 New changes from the livestream
    Starts the layout
    [1.15v_buck.kicad_sch, 3v3_ldo.kicad_sch, 5v_buck.kicad_sch, UFP_MUX.kicad_sch, USB_HUB.kicad_sch, input_filter.kicad_sch, mte_usb_hub.kicad_pcb, mte_usb_hub.kicad_sch]
2021-06-26 Fixes the broken FET footprint, updates to latest nightly
    [mte_usb_hub.kicad_pcb]
2021-06-26 Updates from the livestream
    [1.15v_buck.kicad_sch, 3v3_ldo.kicad_sch, 5v_buck.kicad_sch, UFP_MUX.kicad_sch, USB_HUB.kicad_sch, input_filter.kicad_sch, mte_usb_hub.kicad_pcb, mte_usb_hub.kicad_sch]
2021-07-17 Livestream updates
    [mte_usb_hub.kicad_pcb, usb_a_filter.kicad_sch, usb_c_filter.kicad_sch]
